darthdaver/Ercolino/README.md

Project Aim : Self-Balancing Robot with Arduino and Kalman Filter.

*******************************************************************************

Report
---------
Contains the report of the project.

*******************************************************************************

Ercolino
-------
Contains the source code for the Arduino Uno micro-controller.

*******************************************************************************

Demo
--------
Contains a demonstration video about the functioning of the robot.

*******************************************************************************

Credits
----------

- Alessandro Castiglioni

- Davide Molinelli

*******************************************************************************

Thanks to
-------------

- Jeff Rowberg for the i2C Device Library: https://github.com/jrowberg/i2cdevlib

- Stefan Staub for the Arduino Ticker Library v2.0: https://github.com/sstaub/Ticker
